felipe-m/tfg/memoria y anexos/bibliografia.docx

BIBLIOGRAFIA

TFG DE MONTAJE DE UN ENSAYO ANALOGO https://eprints.ucm.es/33435/1/MemoriaFinal_PIMCD_ModelosAnalogos.pdf

DOCUMENTACION SOBRE LA GEOLOGIA ESTRUCTURAL

http://iesbinef.educa.aragon.es/departam/webinsti/bach/biogeo1/ap3tecto.pdf

https://www.medellin.unal.edu.co/~rrodriguez/geologia/estructural.htm

SOFTWARE LIBRE

https://www.bbva.com/es/que-son-las-licencias-de-codigo-abierto/

HARDWARE LIBRE

https://www.bbva.com/es/que-es-el-hardware-libre/
