felipe-m/tfg/memoria y anexos/Anexo 1. lista de piezas del ensayo de modelo analogo geologico simple.pdf

### LISTA DE PIEZAS DEL ENSAYO DE MODELO ANALOGO GEOLOGICO SIMPLE

Ilustración | nombre | Número
de piezas | proveedor | Enlace de compra

Perfil 30x30
L90mm | 4

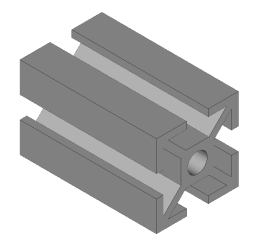
[picture p28: figure]

motedis

https://www.motedis.es/shop/Perfil-Ranurado/Perfil-30-Tipo-B-ranura-8/Perfil-30x30-Tipo-B-ran-8::99999432.html

Perfil 30x30
L250mm | 2

Perfil 30x30
L740mm | 2

Perfil 30x30
L800mm | 4

Perfil 30x30
L810mm | 1

Perfil 30x30
L1060mm | 4

Perfil 30x60
L400mm | 2

motedis

https://www.motedis.es/shop/Perfil-Ranurado/Perfil-30-Tipo-B-ranura-8/Perfil-30x60-Tipo-B-ran-8::99999436.html Perfil 30x60
L1000mm | 2

Eje acero
D20mm
L500mm
2 | motedis

https://www.motedis.es/shop/Modulos/Cojinetedel-bola-20-Forma-de-pe/Eje-acero-deprecision-%D820mm::999996499.html

Husillo TR
8mmx1,5mm | 1 | motedis

https://www.motedis.es/shop/Dinamica-Unidadlineal/Husillo-trapezoidal-accesorios/Husillo-Trapezoidal/Acero-Husillo-de-roscatrapezoidal/Husillo-de-rosca-trapezoidal-R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
L%3D500mm::999993952.html

Soporte eje
SH20/SK20 | 4 | motedis

https://www.motedis.es/shop/Modulos/Cojinetedel-bola-20-Forma-de-pe/Soportes-para-ejes-SH20-SK20::999991255.html

Rodamiento
8mm con brida a 90º | 2 | motedis

https://www.motedis.es/shop/Dinamica-Unidadlineal/Rodamiento-con-brida-90G-KP/Rodamiento-con-brida-90%B0-8mm-KP08::999995357.html

Cojinete
LME20UU | 4 | motedis

https://www.motedis.es/shop/Dinamica-Unidadlineal/Cojinete-lineal/Cojinete-Lineal-Estandarsin-Alojamiento/Cojinete-lineal-20mm-LME20UU::999991278.html

Tuerca
Trapezoidal
de plomo para husillo 8x1,5 R | 1 | motedis

https://www.motedis.es/shop/Dinamica-Unidadlineal/Husillo-trapezoidal-accesorios/Tuerca-Trapezoidal/Tuerca-de-husillo-trapezoidal-Bronce-rojo-con-caja-de-Aluminio/Tr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

Ilustración | nombre | Número
de piezas | proveedor | Enlace de compra

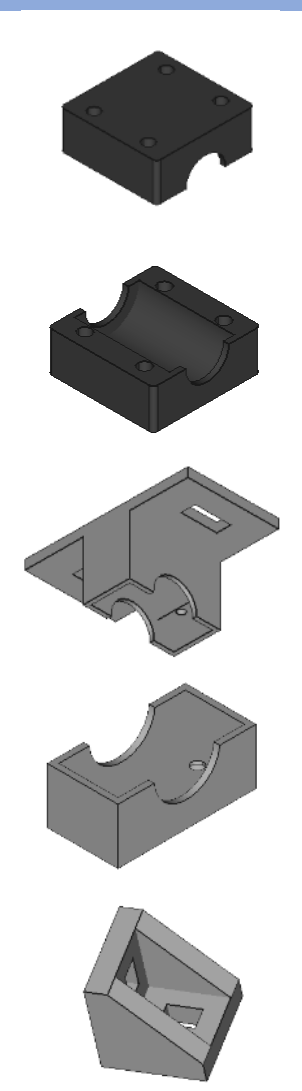
[picture p29: figure]

Soporte
cojinete
LME20UU
(top)
4 | - | IMPRESO 3D

Soporte
cojinete
LME20UU
(botton)
4 | - | IMPRESO 3D

Soporte
Tuerca
husillo (Top)
1 | - | IMPRESO 3D

Soporte
Tuerca
husillo
(botton)
1 | - | IMPRESO 3D

Escuadra; motedis; B::999991057.html

https://www.motedis.es/shop/Accesorios-para-Perfil-Ranurado/Accesorios-Perfil-20-Tipo-B-Ranura-6/Conectores-y-angulos-para-ranura-6-tipo-B/Singleparts/Bracket/Escuad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

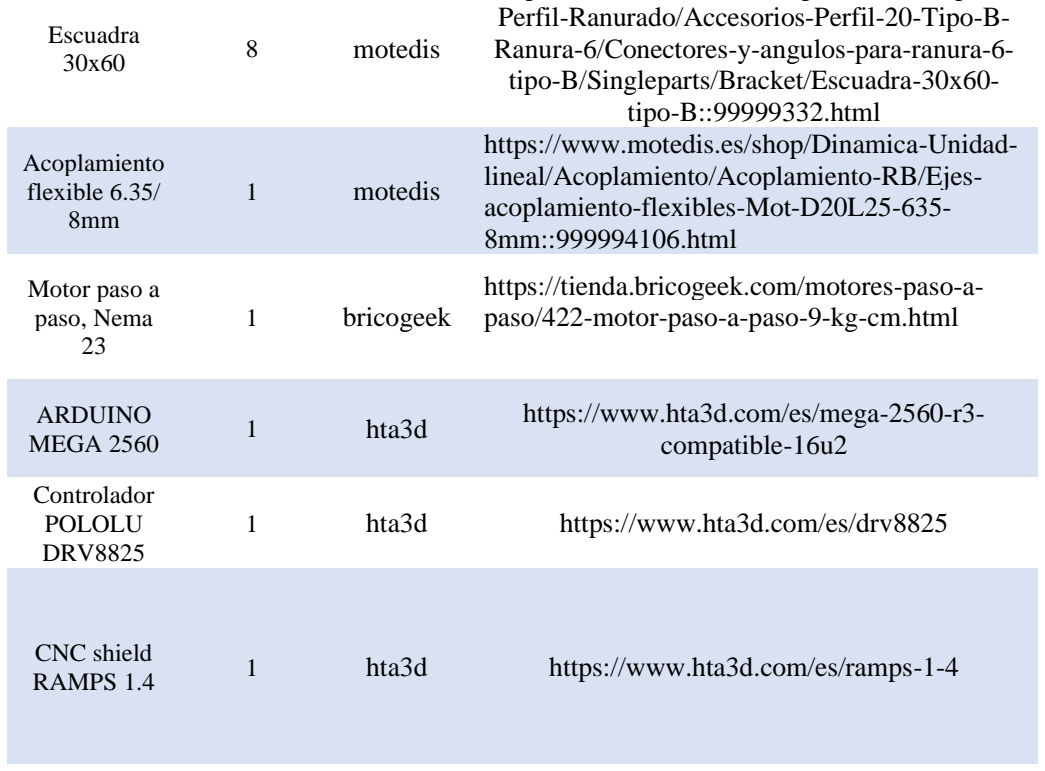
[picture p30: figure]
Escuadra; motedis; Perfil-Ranurado/Accesorios-Perfil-20-Tipo-B- Ranura-6/Conectores-y-angulos-para-ranura-6- tipo-B/Singleparts/Bracket/Escuadra-30x60- tipo-B::99999332.html; Acoplamiento flexible 6.35/ 8mm; https://www.motedis.es/shop/Dinamica-Unidad- lineal/Acoplamiento/Acoplamiento-RB/Ejes- acoplamiento-flexibles-Mot-D20L25-635- 8mm::999994106.html; Motor paso a paso, Nema 23; bricogeek; https://tienda.bricogeek.com/motores-paso-a- paso/422-motor-paso-a-paso-9-kg-cm.html; ARDUINO; MEGA 2560; hta3d; https://www.hta3d.com/es/mega-2560-r3-; compatible-16u2; Controlador POLOLU DRV8825; https://www.hta3d.com/es/drv8825; CNC shield; RAMPS 1.4; https://www.hta3d.com/es/ramps-1-4

https://www.motedis.es/shop/Accesorios-para-

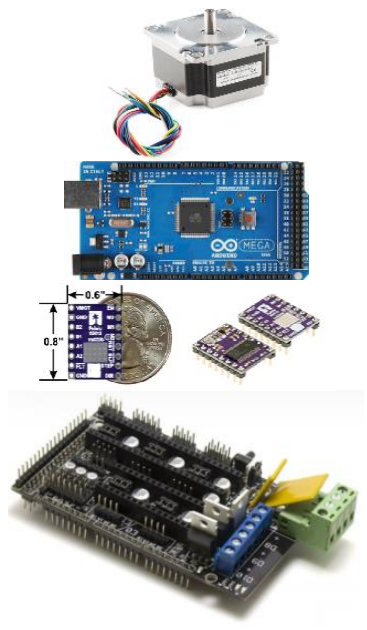
[picture p31: figure]

Ilustración | nombre

Número
de
piezas
proveedor | Enlace de compra

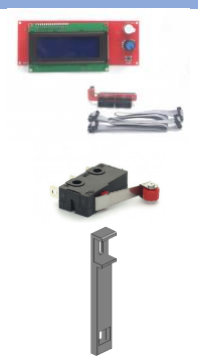
[picture p32: figure]

Pantalla

LCD | 1 | hta3d | https://www.hta3d.com/es/pantalla-2004-lcd- smart-controller
Fin de carrera | 2 | hta3d | https://www.hta3d.com/es/final-carrera- mecanico-kw12-3

Soporte
para fin de carrera | 2 | - | IMPRESO 3D

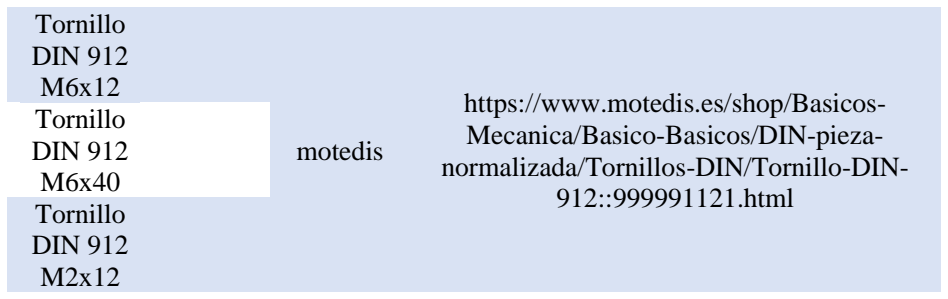
[picture p33: figure]
Tornillo DIN 912 M6x12; motedis; https://www.motedis.es/shop/Basicos- Mecanica/Basico-Basicos/DIN-pieza- normalizada/Tornillos-DIN/Tornillo-DIN- 912::999991121.html; Tornillo DIN 912 M6x40 Tornillo DIN 912 M2x12

Tuerca
Martillo
M6

motedis

https://www.motedis.es/shop/Accesorios-para-Perfil-Ranurado/Accesorios-Perfil-30-Tipo-B-Ranura-8/Sliding-nuts-suitable-for-Nut-8-B-type/Tuerca-martillo-ran-8-tipo-B-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

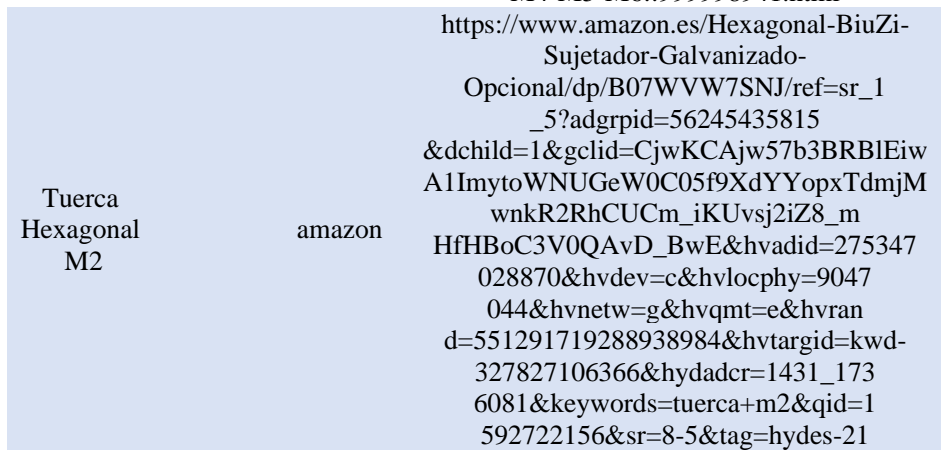
[picture p34: figure]
Tuerca Hexagonal M2; amazon; https://www.amazon.es/Hexagonal-BiuZi- Sujetador-Galvanizado- Opcional/dp/B07WVW7SNJ/ref=sr_1 _5?adgrpid=56245435815 &dchild=1&gclid=CjwKCAjw57b3BRBlEiw A1ImytoWNUGeW0C05f9XdYYopxTdmjM wnkR2RhCUCm_iKUvsj2iZ8_m HfHBoC3V0QAvD_BwE&hvadid=275347 028870&hvdev=c&hvlocphy=9047 044&hvnetw=g&hvqmt=e&hvran d=551291719288938984&hvtargid=kwd- 327827106366&hydadcr=1431_173 6081&keywords=tuerca+m2&qid=1 592722156&sr=8-5&tag=hydes-21
