felipe-m/tfg/archivosparaimprimir3D/soporteTUERCAHUSILLObot.stl

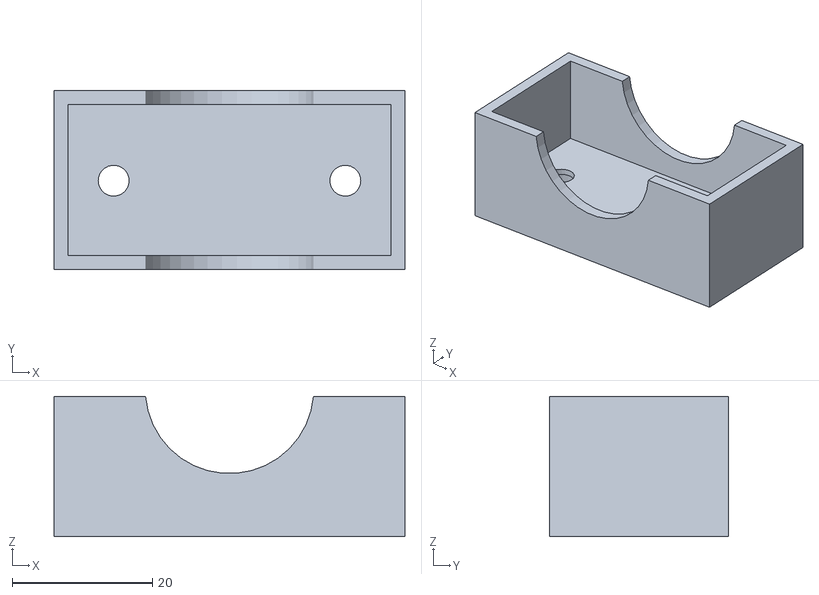
[picture p38: CAD file, 2020-06-21]
archivosparaimprimir3D/soporteTUERCAHUSILLObot.stl
50.0 x 25.5 x 20.0
