felipe-m/tfg/fcad/diseños alternativos/diseñoensayosimple.FCStd

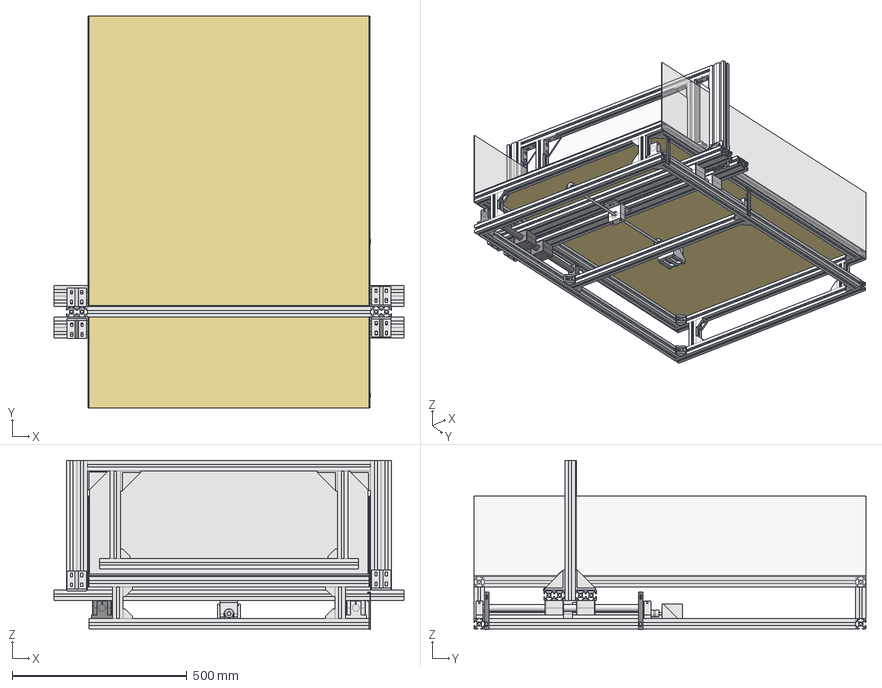
[picture p39: CAD file, 2020-08-21]
fcad/diseños alternativos/diseñoensayosimple.FCStd
1000.0 x 1120.0 x 483.0 mm
base_001
soporteFC001
soporteFC
sistema soporte_001
sistema soporte_002
puentemovil_001
sistema de transmision_001
paneltransparente_001
paneltransparente_002
panelopacobase_001
panelopacoempuje_001
