felipe-m/tfg/fcad/etapasdediseño/PLANOetapa3.FCStd

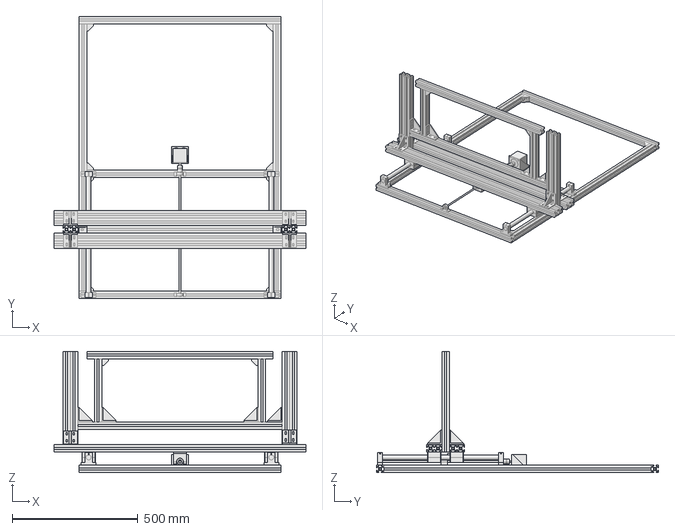
[picture p40: CAD file, 2020-06-21]
fcad/etapasdediseño/PLANOetapa3.FCStd
1000.0 x 1120.0 x 482.0 mm
