felipe-m/tfg/fcad/piezasimpresas/soporteMOTOR.FCStd

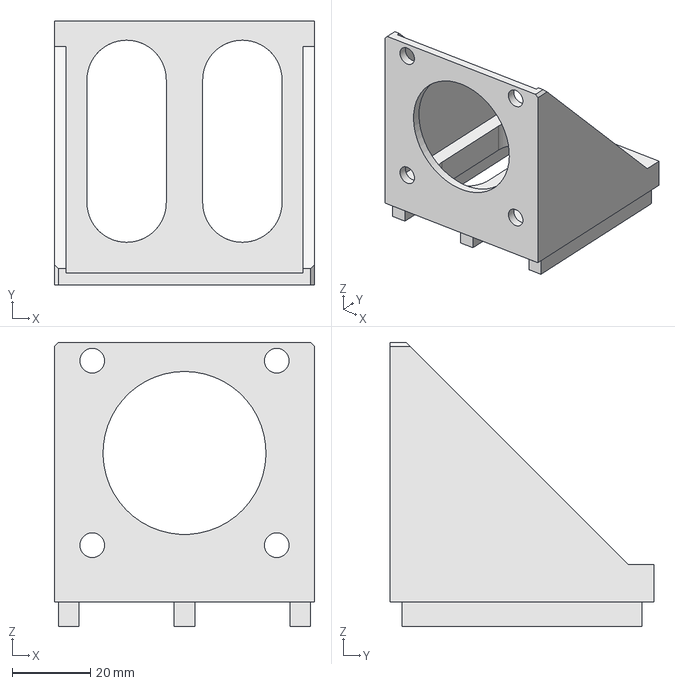
[picture p41: CAD file, 2020-08-21]
fcad/piezasimpresas/soporteMOTOR.FCStd
66.4 x 67.4 x 72.5 mm
