felipe-m/tfg/fcad/sistemas del diseño/PLANOpuentemovil.FCStd

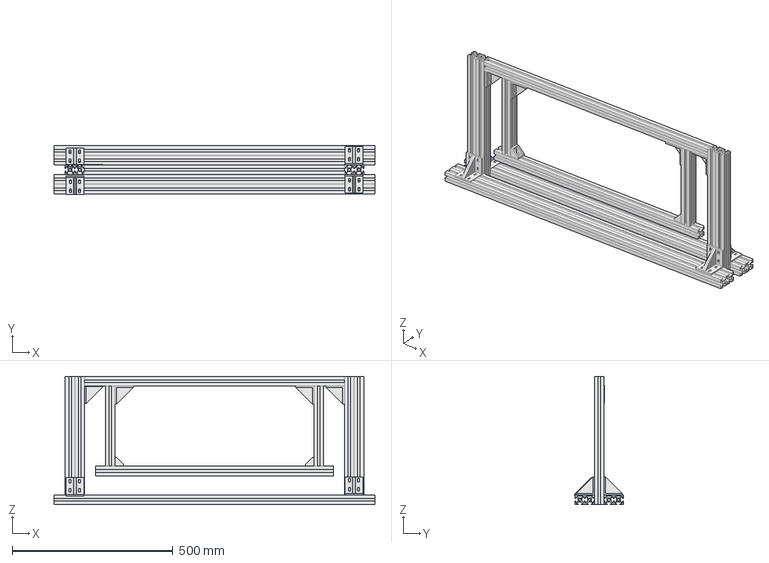
[picture p42: CAD file, 2020-08-21]
fcad/sistemas del diseño/PLANOpuentemovil.FCStd
1000.0 x 151.3 x 400.0 mm
