felipe-m/tfg/fcad/unionesroscadas/union_rodamiento8mm.FCStd

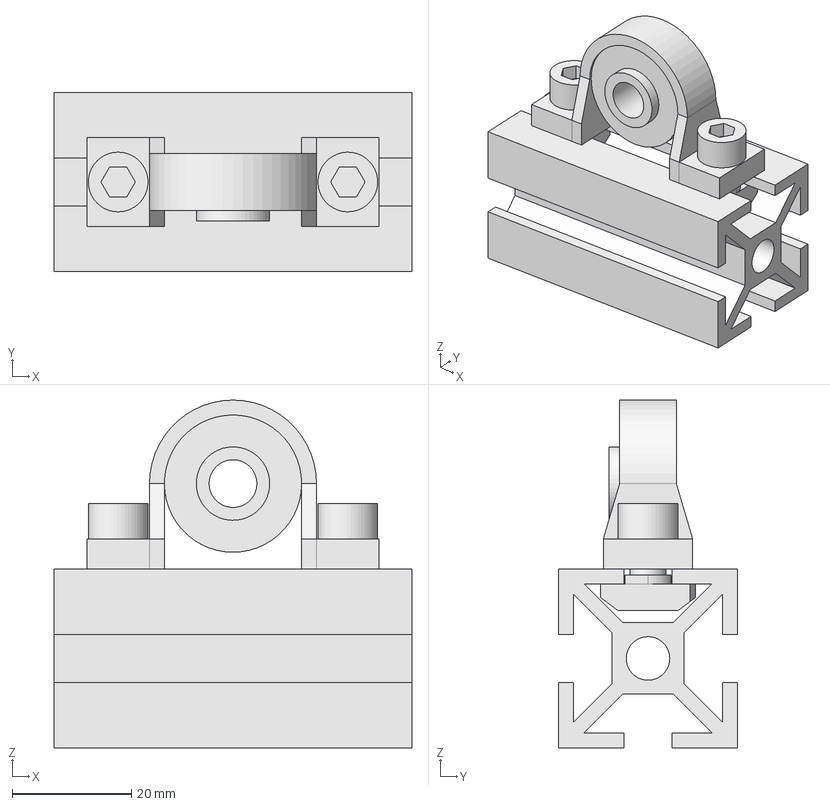
[picture p43: CAD file, 2020-09-22]
fcad/unionesroscadas/union_rodamiento8mm.FCStd
60.0 x 30.0 x 58.3 mm
