felipe-m/tfg/archivosparaimprimir3D/soporteCOJINETEtop.stl

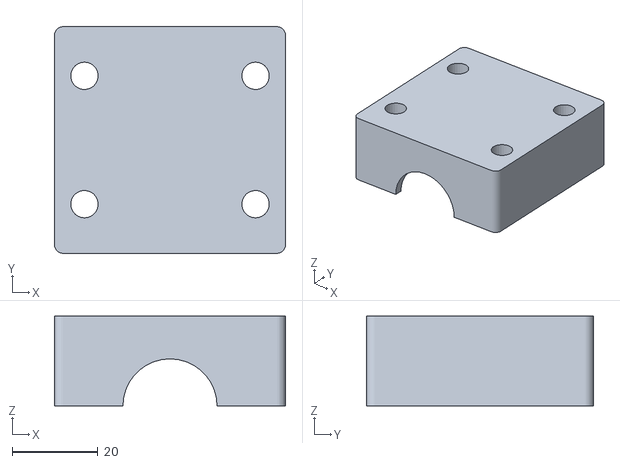
[picture p44: CAD file, 2020-06-21]
archivosparaimprimir3D/soporteCOJINETEtop.stl
54.0 x 53.0 x 21.0
