felipe-m/tfg/fcad/diseños alternativos/prototipo.FCStd

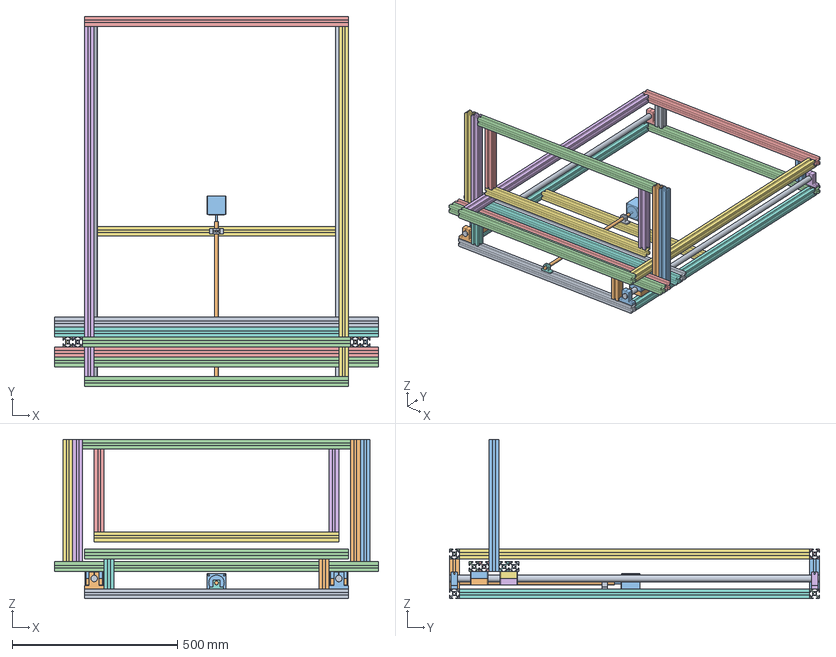
[picture p45: CAD file, 2020-05-18]
fcad/diseños alternativos/prototipo.FCStd
980.0 x 1120.0 x 482.0 mm
alu_travesano_base_y0
sh__y0_xn
sh__y0_x
alu_travesano_base_y1
sh__y1_xn
sh__y1_x
travesano_int
alu_largo_base_xn
linbearhouse_top
linbearhouse_bot
linbearhouse_top001
linbearhouse_bot001
alu_port_vn
alu_port_vn001
alu_largo_base_x
linbearhouse_top002
linbearhouse_bot002
alu_car
alu_car001
linbearhouse_top003
linbearhouse_bot003
alu_car002
alu_car003
alu_port_vp
alu_port_vp001
top_gantry
alu_port_vp002
alu_port_vp003
alu_base_empuje
alu_v
alu_v001
alu_v002
alu_v003
alu_travesano_mesa_y0
alu_travesano_mesa_y1
alu_largo_mesa_xn
alu_largo_mesa_x
pillow__y0
pillow__y1
nema23_motor_l56
