felipe-m/tfg/fcad/etapasdediseño/PLANOetapa2.FCStd

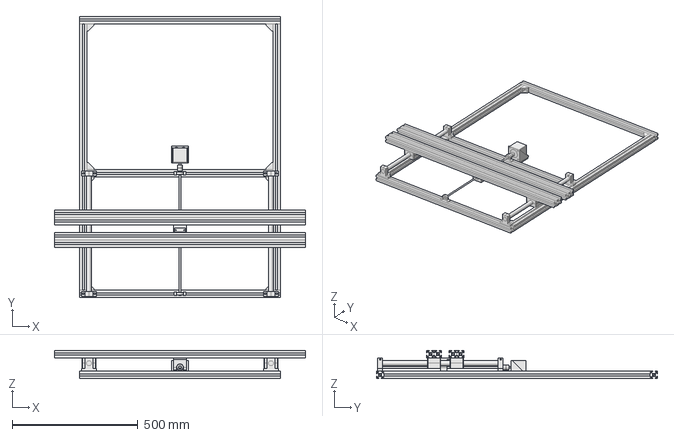
[picture p46: CAD file, 2020-06-21]
fcad/etapasdediseño/PLANOetapa2.FCStd
1000.0 x 1120.0 x 112.0 mm
