felipe-m/tfg/fcad/piezasimpresas/soporteCOJINETE.FCStd

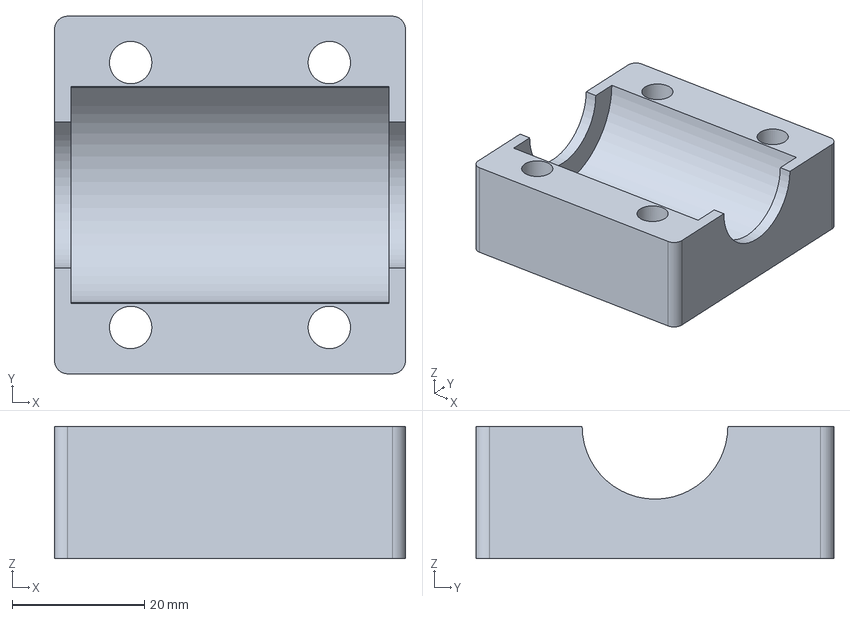
[picture p47: CAD file, 2020-08-21]
fcad/piezasimpresas/soporteCOJINETE.FCStd
53.0 x 54.0 x 20.0 mm
