felipe-m/tfg/fcad/sistemas del diseño/PLANOsistematransmision.FCStd

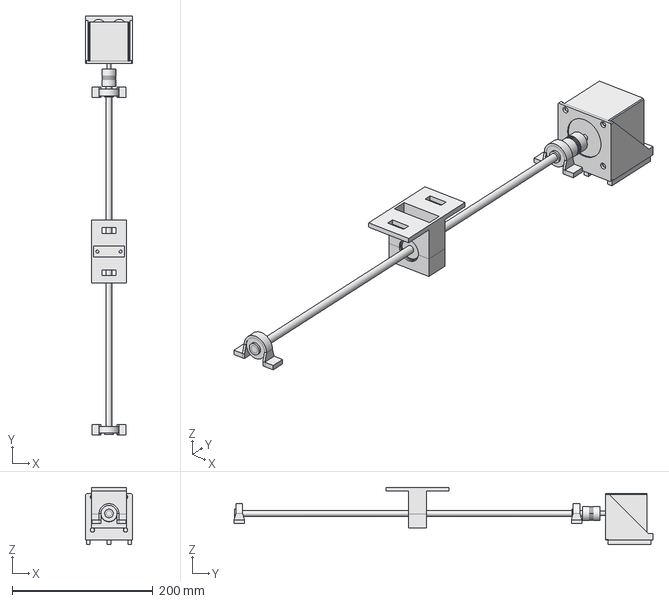
[picture p48: CAD file, 2020-08-21]
fcad/sistemas del diseño/PLANOsistematransmision.FCStd
66.4 x 596.3 x 81.4 mm
