felipe-m/tfg/fcad/unionesroscadas/union_cojinete LME20UU.FCStd

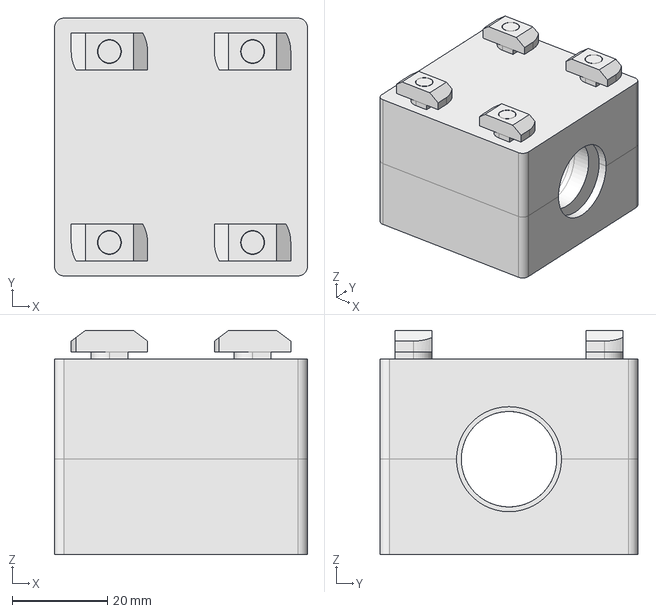
[picture p49: CAD file, 2020-06-21]
fcad/unionesroscadas/union_cojinete LME20UU.FCStd
53.0 x 54.0 x 47.0 mm
