felipe-m/tfg/fcad/etapasdediseño/PLANOetapa1.FCStd

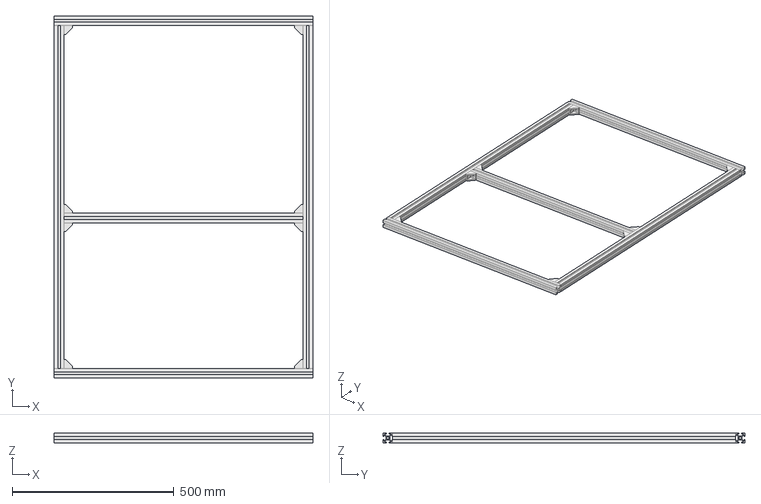
[picture p50: CAD file, 2020-06-21]
fcad/etapasdediseño/PLANOetapa1.FCStd
800.0 x 1120.0 x 30.0 mm
