felipe-m/tfg/fcad/piezasimpresas/soporteFINDECARRERA.FCStd

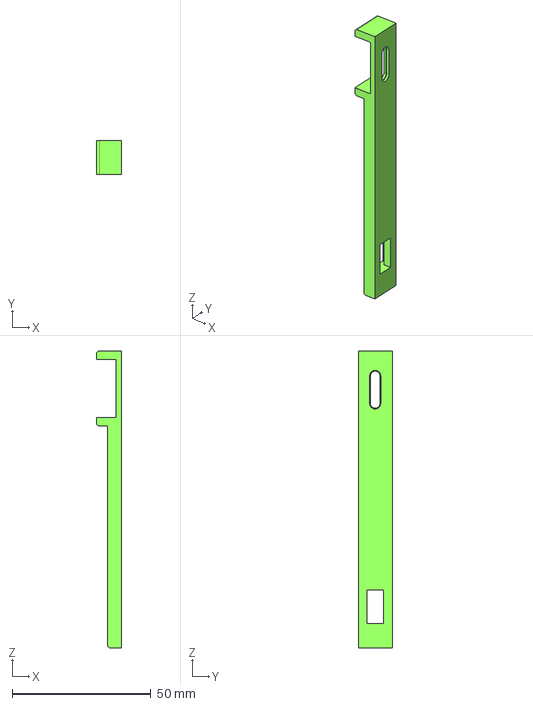
[picture p51: CAD file, 2020-08-21]
fcad/piezasimpresas/soporteFINDECARRERA.FCStd
9.00 x 12.2 x 107.0 mm
