felipe-m/tfg/fcad/sistemas del diseño/PLANOsistemaapoyo.FCStd

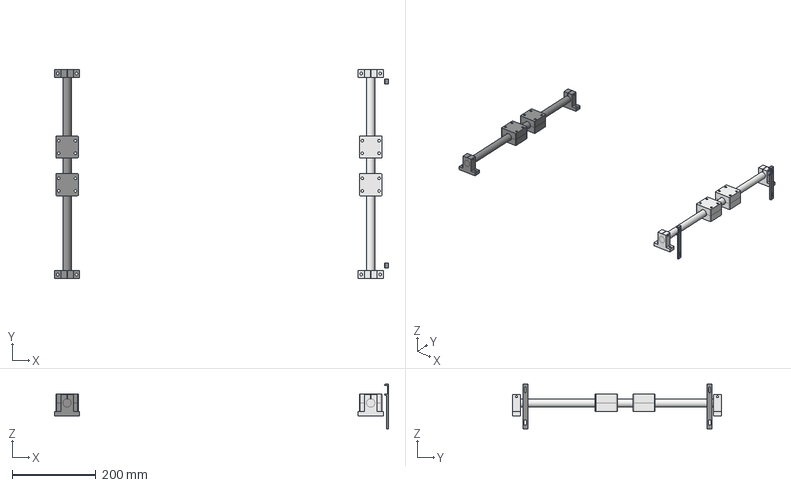
[picture p52: CAD file, 2020-06-21]
fcad/sistemas del diseño/PLANOsistemaapoyo.FCStd
797.5 x 500.0 x 107.0 mm
soporteFC
soporteFC001
sist soporte_002
sist soporte_001
