felipe-m/tfg/fcad/unionesroscadas/union_escuadra3030.FCStd

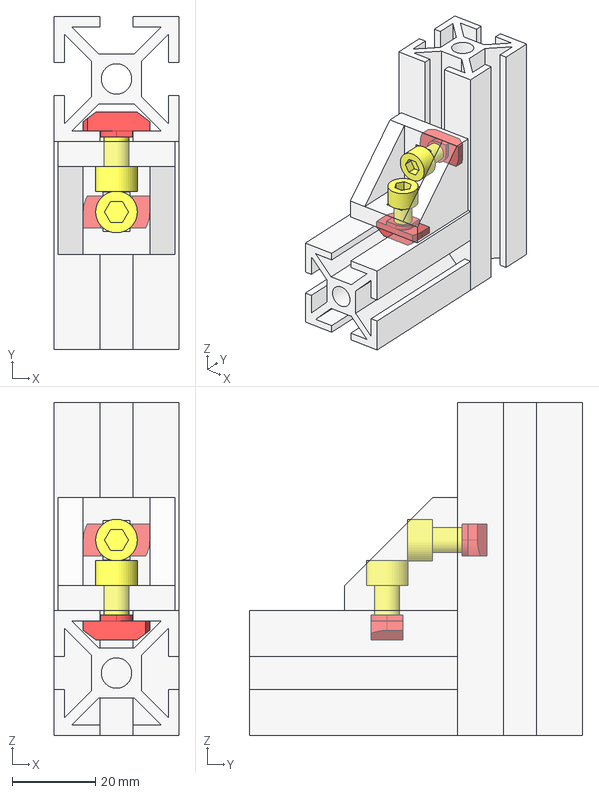
[picture p53: CAD file, 2020-06-21]
fcad/unionesroscadas/union_escuadra3030.FCStd
30.0 x 80.0 x 80.0 mm
escuadra 30x30_001
d912bolt_m6_l12_001
d912bolt_m6_l12_002
aluprof_30x30_001
tuercaMartilloM6_001
tuercaMartilloM6_002
aluprof_30x30_002
