felipe-m/tfg/fcad/etapasdediseño/PLANOetapa4.FCStd

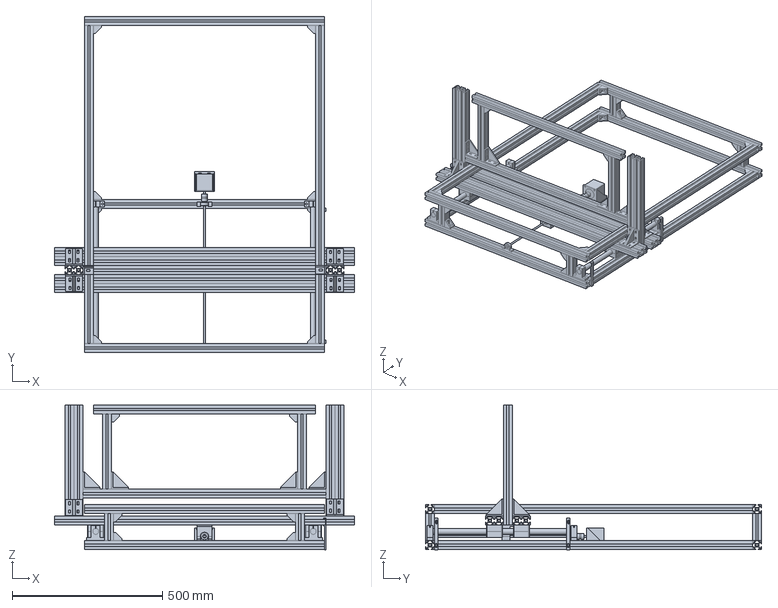
[picture p54: CAD file, 2020-06-21]
fcad/etapasdediseño/PLANOetapa4.FCStd
1000.0 x 1120.0 x 483.0 mm
