felipe-m/tfg/fcad/piezasimpresas/soporteTUERCAHUSILLO.FCStd

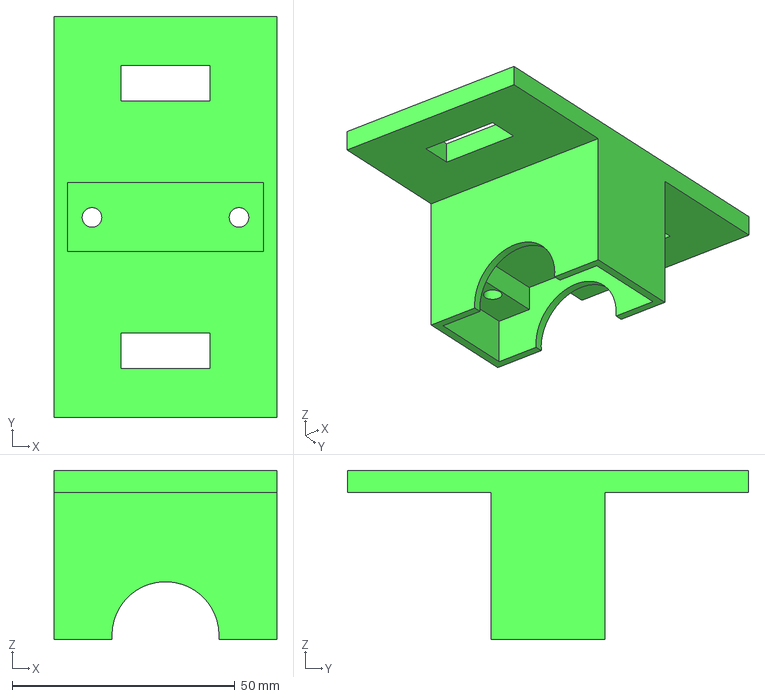
[picture p55: CAD file, 2020-08-21]
fcad/piezasimpresas/soporteTUERCAHUSILLO.FCStd
50.0 x 90.0 x 38.0 mm
