felipe-m/tfg/fcad/unionesroscadas/union_soporteEJEacero.FCStd

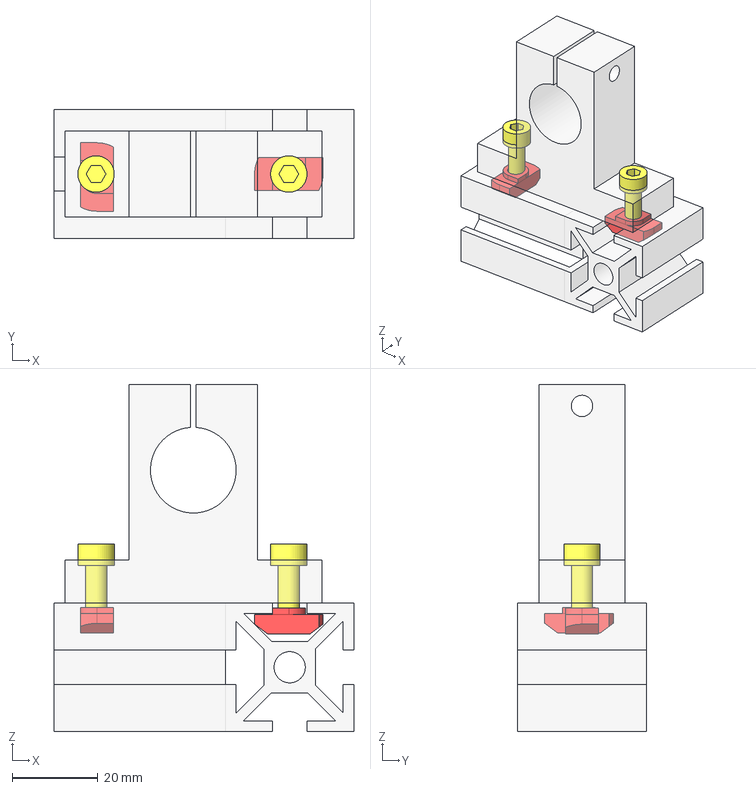
[picture p56: CAD file, 2020-06-21]
fcad/unionesroscadas/union_soporteEJEacero.FCStd
70.0 x 30.0 x 81.0 mm
sh__y0_x
tuercaMartilloM5_001
tuercaMartilloM5_002
d912bolt_m5_l15
d912bolt_m5_l016
