felipe-m/tfg/fcad/unionesroscadas/union_tuercahusillo.FCStd

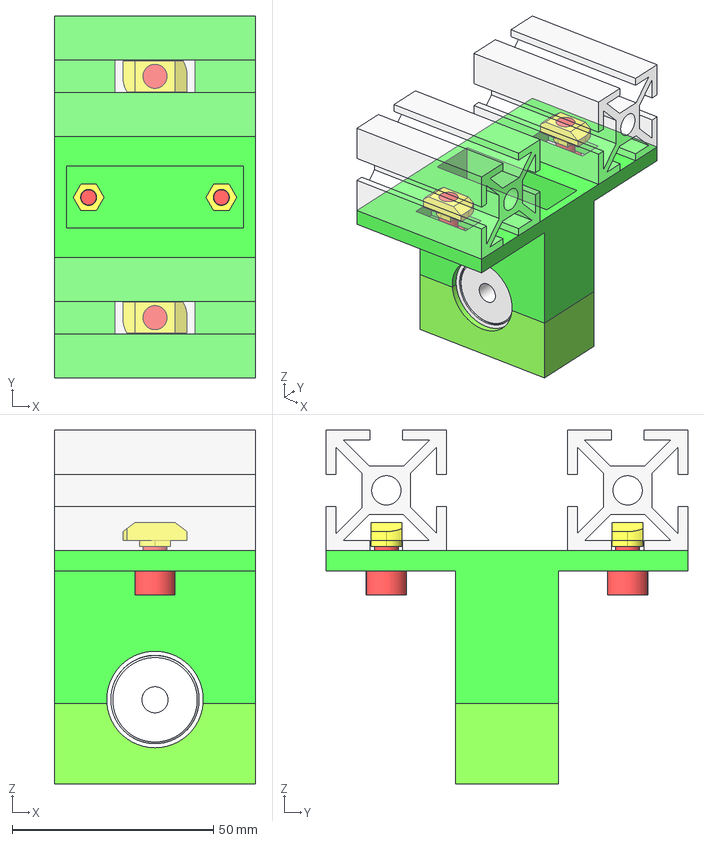
[picture p57: CAD file, 2020-06-21]
fcad/unionesroscadas/union_tuercahusillo.FCStd
50.0 x 90.0 x 88.0 mm
TUERCAHUSILLO
d912bolt_m4_l40_001
d912bolt_m4_l40_002
d934nut_m4
d934nut_m005
aluprof_30
aluprof_031
d912bolt_m6_l12
d912bolt_m6_l013
tuercaMartilloM5_001
tuercaMartilloM5_002
soporteTUERCAHUSILLOtop
soporteTUERCAHUSILLObot
