felipe-m/tfg/fcad/unionesroscadas/union_escuadra6060.FCStd

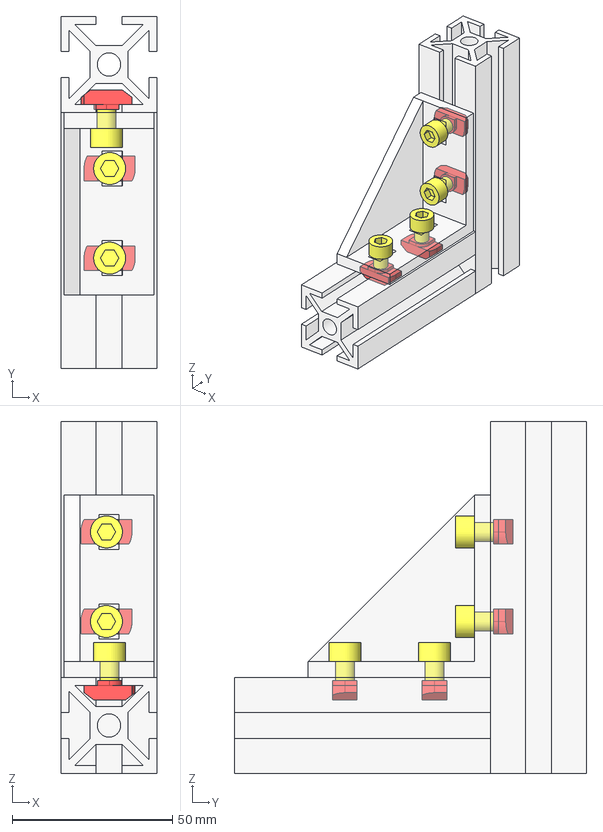
[picture p58: CAD file, 2020-06-21]
fcad/unionesroscadas/union_escuadra6060.FCStd
30.0 x 110.0 x 110.0 mm
escuadra 30x60_001
tornillo_m6_l12_001
tornillo_m6_l12_002
tornillo_m6_l12_003
tornillo_m6_l12_004
tuercaMartilloM6_001
tuercaMartilloM6_002
tuercaMartilloM6_003
tuercaMartilloM6_004
aluprof_30x30_001
aluprof_30x30_002
