felipe-m/tfg/fcad/unionesroscadas/union_soportefindecarrera.FCStd

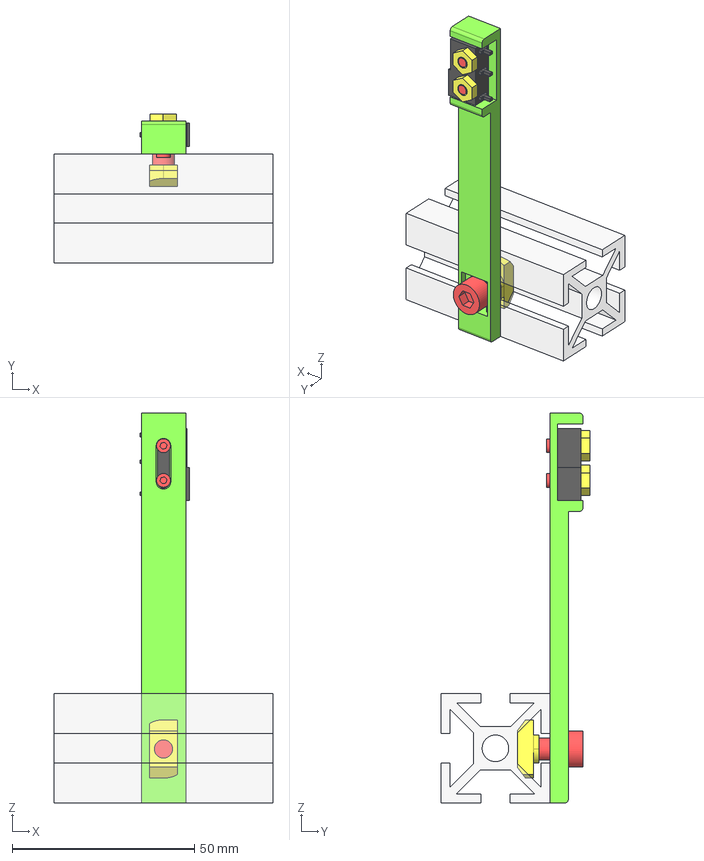
[picture p59: CAD file, 2020-06-21]
fcad/unionesroscadas/union_soportefindecarrera.FCStd
60.0 x 41.0 x 107.0 mm
findecarrera
tuercaMartilloM5_001
d912bolt_m6_l12
aluprof_30
D912BOLT_m2_L12
D912BOLT_m2_L013
tuerca m2
tuerca m2 _002
soporteFC
