felipe-m/tfg/(list of files, cad)

Other CAD files:
archivosparaimprimir3D/soporteMOTOR.stl
archivosparaimprimir3D/soporteCOJINETEbot.stl
archivosparaimprimir3D/soporteTUERCAHUSILLOtop.stl
