felipe-m/tfg/(commit log)

2019-10-17 Primera version de las correderas
    Hay que modificarlas
    [corredera-inferior.FCStd, corredera-superior.FCStd]
2019-10-17 Anado el fichero readme
2019-10-24 Se ha anadido tolerancias y hueco para rodamiento
    inserte la corredera
    [corredera-inferior.FCStd, corredera-inferior.stl, corredera-superior.FCStd]
2019-10-31 version 3.0 adehesion de correderas normalizadas
    se introducen versiones normalizadas de las correderas y se sustitullen
    por las hechas a mano y se incluyen archivos exportables al programa
    CURA 4.3 para imprimir en 3D
    [corredera-inferior.FCStd, corredera-inferior.stl, corredera-superior.FCStd]
2019-10-31 version 3.1 subimos los archivos normalizados
    se han cambiado los archivos corredera inferior y superior por
    un elemento normalizado, y archivos para CURA 4.3
    [corredera-superior.stl]
2019-11-14 inclusion del paquete de freecad mecatronica
    en esta actualización utilizamos las piezas del paquete de freecad
    mecatronica de acceso publico en freecad.
    se incluyen los archivos en .FCStd y en .stl
    [corredera-inferior.FCStd, corredera-inferior.stl, corredera-superior.FCStd, corredera-superior.stl]
2019-11-19 añadido el .gitignore y borrados archivos temporales
2019-11-20 cambiamos a los modelos SCE20UU_PR30b
    estos modelos se ajustan mejor a la separacion de los huecos
    para colocar los tornillos M5 en los perfiles de 30mm de la estructura
    [corredera-inferior.FCStd, corredera-inferior.stl, corredera-superior.FCStd, corredera-superior.stl]
2020-03-11 subimos un codigo para arduino para controlar una pantalla DISCOUNT el archivo aun no controla el motor, solo la pantalla
    new file: pantallaDISCOUNTarduino/pantallaDISCOUNTarduino.ino
    subimos un diseño de la estructura de nuestro tfg
    new file: fcad/estructura.FCStd
    [estructura.FCStd]
2020-03-24 en esta actualizacion se introduce un pdf de memoria del tfg en esta version se incluye:
    -introduccion
    -lista de piezas y datos tecnicos
2020-04-20 Actualizamos la memoria del TFG y añadimos el programa completo de arduino
2020-05-18 en este commit :
    -actualizamos la memoria en funcion de los datos reales de las piezas
    -terminamos calculos de resistencia y realizamos cambios en el diseño original
    -realizamos un presupuesto
    -introducimos diseños de freecad del diseño final y del diseño de mejora
    -introduciomos planos de detalle y del montaje
    [corredera-inferior.FCStd, corredera-inferior.stl, corredera-superior.FCStd, corredera-superior.stl, diseñoFinal.FCStd, diseñofinal.FCStd, estructura.FCStd, prototipo.FCStd]
2020-05-21 en este commit actualizamos los planos para incluir cotas y aumentar el detalle
2020-06-21 En esta actualizacion se han reorganizado las carpetas para facilitar su interpretacion y se han actualizado los archivos:
    se ha introducido una carpeta de archivos para imprimir
    en esta carpeta se pueden encontrar tanto los archivos para el programa CuraMaker como las mallas de Freecad
    se ha introducido una carpeta de archivos Frecad
    en esta carpeta se pueden encontrar diseños detallados del diseño de freecad,
    incluye diseño de cada pieza de Freecad, diseño de cada union roscada, de cada sistema del diseño y de los diferentes modelos de diseño que se trabajan
    se ha actualizado la carpeta de memoria y anexos
    se actualiza la memoria e incluyen anexos interesante
    se incluye u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
    [PLANOetapa1.FCStd, PLANOetapa2.FCStd, PLANOetapa3.FCStd, PLANOetapa4.FCStd, PLANOpuentemovil.FCStd, PLANOsistemaapoyo.FCStd, PLANOsistematransmision.FCStd, diseñoFinal.FCStd]
2020-08-21 En esta actualización se corrigen faltas de ortografia de la memoria y se actualizan e incluyen planos
    [PLANOpuentemovil.FCStd, PLANOsistematransmision.FCStd, diseñoensayosimple.FCStd, soporteCOJINETE.FCStd, soporteCOJINETEbot.stl, soporteCOJINETEtop.stl, soporteFINDECARRERA.FCStd, soporteMOTOR.FCStd]
2020-10-06 Documentos para el diseño de una mesa de modelado
